wcaokaze/NotEnoughCompromises/scad/CircuitBoard.scad

circuit_board_thickness = 0.6;
