wcaokaze/NotEnoughCompromises/scad/PrinterSpec.scad

// 他のパーツと接触する部分において干渉を避けるために余分に開ける空間の大きさ
printer_min_margin = 0.1;
