wcaokaze/NotEnoughCompromises/scad/RubberFeet.scad

include <KeySwitch.scad>

rubber_feet_material_min_thickness = 1.0;

rubber_feet_thickness = rubber_feet_material_min_thickness;
