wcaokaze/NotEnoughCompromises/pcb/NotEnoughCompromises.kicad_pcb

## KiCad design pcb/NotEnoughCompromises.kicad_pcb (2024-10-13)

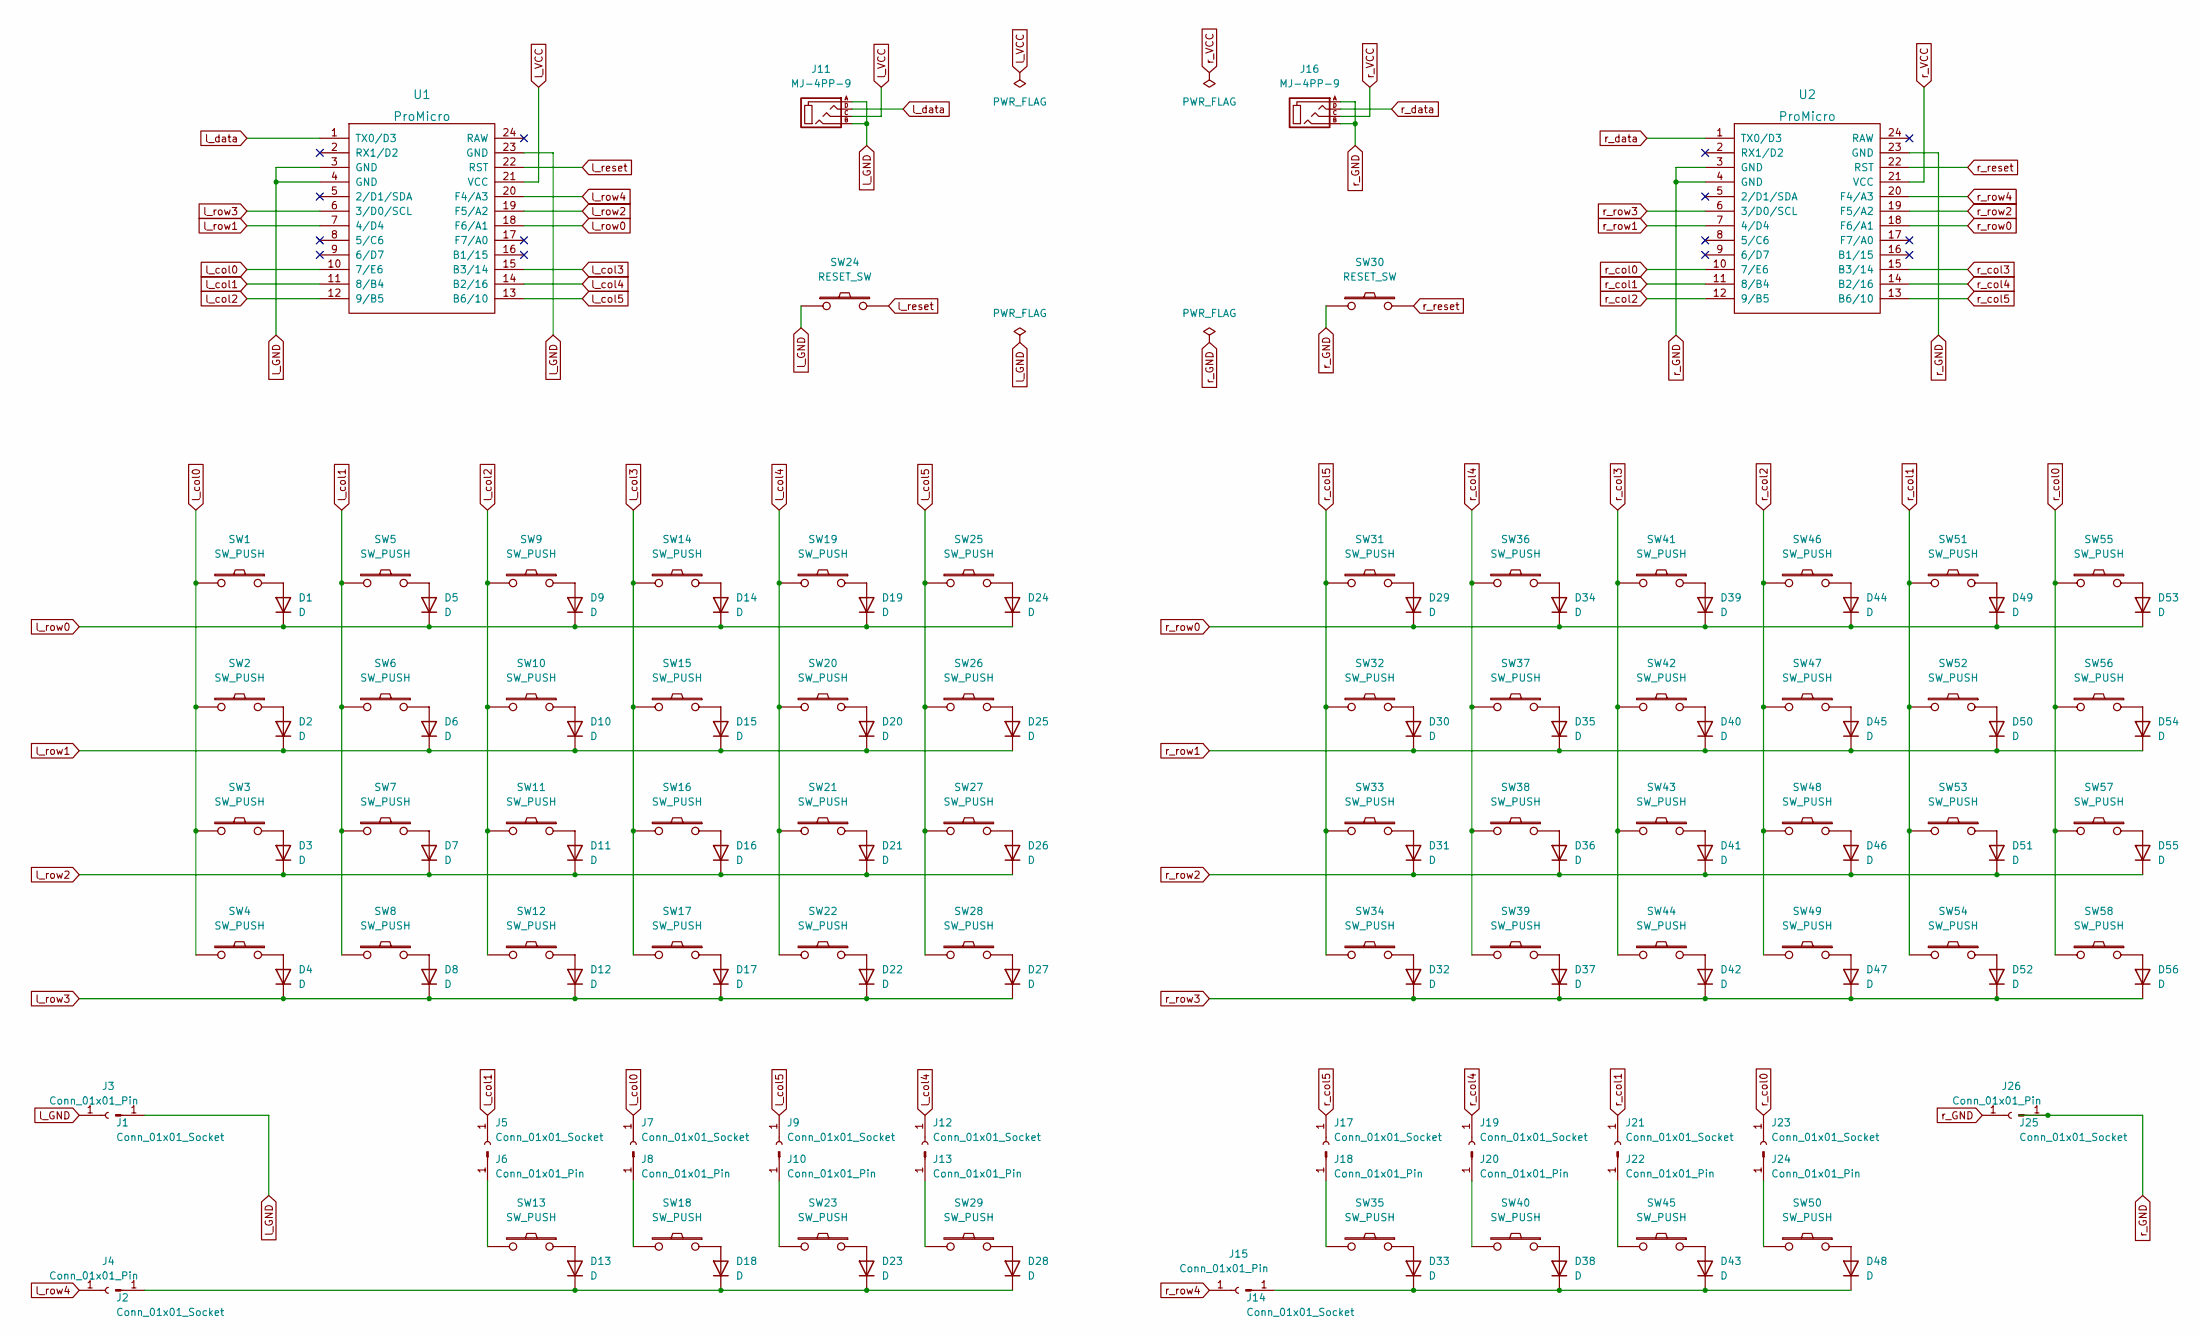
[picture p1: schematic NotEnoughCompromises.kicad_sch]

Parts:
D1, D2, D3, D4, D5, D6, D7, D8, D9, D10, D11, D12, D13, D14, D15, D16, D17, D18, D19, D20, D21, D22, D23, D24, D25, D26, D27, D28, D29, D30, D31, D32, D33, D34, D35, D36, D37, D38, D39, D40, D41, D42, D43, D44, D45, D46, D47, D48, D49, D50, D51, D52, D53, D54, D55, D56: D; D3_SMD_v2
J1, J2, J5, J7, J9, J12, J14, J17, J19, J21, J23, J25: Conn_01x01_Socket; SolderWirePad_1x01_SMD_1x2mm
J3, J4, J6, J8, J10, J13, J15, J18, J20, J22, J24, J26: Conn_01x01_Pin; SolderWirePad_1x01_SMD_1x2mm
J11, J16: MJ-4PP-9; MJ-4PP-9_1side
SW1, SW2, SW3, SW4, SW5, SW6, SW7, SW8, SW9, SW10, SW11, SW12, SW13, SW14, SW15, SW16, SW17, SW18, SW19, SW20, SW21, SW22, SW23, SW25, SW26, SW27, SW28, SW29, SW31, SW32, SW33, SW34, SW35, SW36, SW37, SW38, SW39, SW40, SW41, SW42, SW43, SW44, SW45, SW46, SW47, SW48, SW49, SW50, SW51, SW52, SW53, SW54, SW55, SW56, SW57, SW58: SW_PUSH; choc_v1
SW24, SW30: RESET_SW; reset_sw
U1, U2: ProMicro; ProMicro_v3.5

Connections:
unnamed: D1.2 (A), SW1.1
unnamed: D2.2 (A), SW2.1
unnamed: D3.2 (A), SW3.1
unnamed: D4.2 (A), SW4.1
unnamed: D5.2 (A), SW5.1
unnamed: D6.2 (A), SW6.1
unnamed: D7.2 (A), SW7.1
unnamed: D8.2 (A), SW8.1
unnamed: D9.2 (A), SW9.1
unnamed: D10.2 (A), SW10.1
unnamed: D11.2 (A), SW11.1
unnamed: D12.2 (A), SW12.1
unnamed: D13.2 (A), SW13.1
unnamed: D13.1 (K), D18.1 (K), D23.1 (K), D28.1 (K), J4.1
unnamed: D14.2 (A), SW14.1
unnamed: D15.2 (A), SW15.1
unnamed: D16.2 (A), SW16.1
unnamed: D17.2 (A), SW17.1
unnamed: D18.2 (A), SW18.1
unnamed: D19.2 (A), SW19.1
unnamed: D20.2 (A), SW20.1
unnamed: D21.2 (A), SW21.1
unnamed: D22.2 (A), SW22.1
unnamed: D23.2 (A), SW23.1
unnamed: D24.2 (A), SW25.1
unnamed: D25.2 (A), SW26.1
unnamed: D26.2 (A), SW27.1
unnamed: D27.2 (A), SW28.1
unnamed: D28.2 (A), SW29.1
unnamed: D29.2 (A), SW31.1
unnamed: D30.2 (A), SW32.1
unnamed: D31.2 (A), SW33.1
unnamed: D32.2 (A), SW34.1
unnamed: D33.2 (A), SW35.1
unnamed: D33.1 (K), D38.1 (K), D43.1 (K), D48.1 (K), J15.1
unnamed: D34.2 (A), SW36.1
unnamed: D35.2 (A), SW37.1
unnamed: D36.2 (A), SW38.1
unnamed: D37.2 (A), SW39.1
unnamed: D38.2 (A), SW40.1
unnamed: D39.2 (A), SW41.1
unnamed: D40.2 (A), SW42.1
unnamed: D41.2 (A), SW43.1
unnamed: D42.2 (A), SW44.1
unnamed: D43.2 (A), SW45.1
unnamed: D44.2 (A), SW46.1
unnamed: D45.2 (A), SW47.1
unnamed: D46.2 (A), SW48.1
unnamed: D47.2 (A), SW49.1
unnamed: D48.2 (A), SW50.1
unnamed: D49.2 (A), SW51.1
unnamed: D50.2 (A), SW52.1
unnamed: D51.2 (A), SW53.1
unnamed: D52.2 (A), SW54.1
unnamed: D53.2 (A), SW55.1
unnamed: D54.2 (A), SW56.1
unnamed: D55.2 (A), SW57.1
unnamed: D56.2 (A), SW58.1
unnamed: J6.1, SW13.2
unnamed: J8.1, SW18.2
unnamed: J10.1, SW23.2
unnamed: J13.1, SW29.2
unnamed: J18.1, SW35.2
unnamed: J20.1, SW40.2
unnamed: J22.1, SW45.2
unnamed: J24.1, SW50.2
l_GND: J1.1, J3.1, J11.A, J11.B, SW24.1, U1.3 (GND), U1.4 (GND), U1.23 (GND)
l_VCC: J11.C, U1.21 (VCC)
l_col0: J7.1, SW1.2, SW2.2, SW3.2, SW4.2, U1.10 (7/E6)
l_col1: J5.1, SW5.2, SW6.2, SW7.2, SW8.2, U1.11 (8/B4)
l_col2: SW9.2, SW10.2, SW11.2, SW12.2, U1.12 (9/B5)
l_col3: SW14.2, SW15.2, SW16.2, SW17.2, U1.15 (B3/14)
l_col4: J12.1, SW19.2, SW20.2, SW21.2, SW22.2, U1.14 (B2/16)
l_col5: J9.1, SW25.2, SW26.2, SW27.2, SW28.2, U1.13 (B6/10)
l_data: J11.D, U1.1 (TX0/D3)
l_reset: SW24.2, U1.22 (RST)
l_row0: D1.1 (K), D5.1 (K), D9.1 (K), D14.1 (K), D19.1 (K), D24.1 (K), U1.18 (F6/A1)
l_row1: D2.1 (K), D6.1 (K), D10.1 (K), D15.1 (K), D20.1 (K), D25.1 (K), U1.7 (4/D4)
l_row2: D3.1 (K), D7.1 (K), D11.1 (K), D16.1 (K), D21.1 (K), D26.1 (K), U1.19 (F5/A2)
l_row3: D4.1 (K), D8.1 (K), D12.1 (K), D17.1 (K), D22.1 (K), D27.1 (K), U1.6 (3/D0/SCL)
l_row4: J2.1, U1.20 (F4/A3)
r_GND: J16.A, J16.B, J25.1, J26.1, SW30.1, U2.3 (GND), U2.4 (GND), U2.23 (GND)
r_VCC: J16.C, U2.21 (VCC)
r_col0: J23.1, SW55.2, SW56.2, SW57.2, SW58.2, U2.10 (7/E6)
r_col1: J21.1, SW51.2, SW52.2, SW53.2, SW54.2, U2.11 (8/B4)
r_col2: SW46.2, SW47.2, SW48.2, SW49.2, U2.12 (9/B5)
r_col3: SW41.2, SW42.2, SW43.2, SW44.2, U2.15 (B3/14)
r_col4: J19.1, SW36.2, SW37.2, SW38.2, SW39.2, U2.14 (B2/16)
r_col5: J17.1, SW31.2, SW32.2, SW33.2, SW34.2, U2.13 (B6/10)
r_data: J16.D, U2.1 (TX0/D3)
r_reset: SW30.2, U2.22 (RST)
r_row0: D29.1 (K), D34.1 (K), D39.1 (K), D44.1 (K), D49.1 (K), D53.1 (K), U2.18 (F6/A1)
r_row1: D30.1 (K), D35.1 (K), D40.1 (K), D45.1 (K), D50.1 (K), D54.1 (K), U2.7 (4/D4)
r_row2: D31.1 (K), D36.1 (K), D41.1 (K), D46.1 (K), D51.1 (K), D55.1 (K), U2.19 (F5/A2)
r_row3: D32.1 (K), D37.1 (K), D42.1 (K), D47.1 (K), D52.1 (K), D56.1 (K), U2.6 (3/D0/SCL)
r_row4: J14.1, U2.20 (F4/A3)

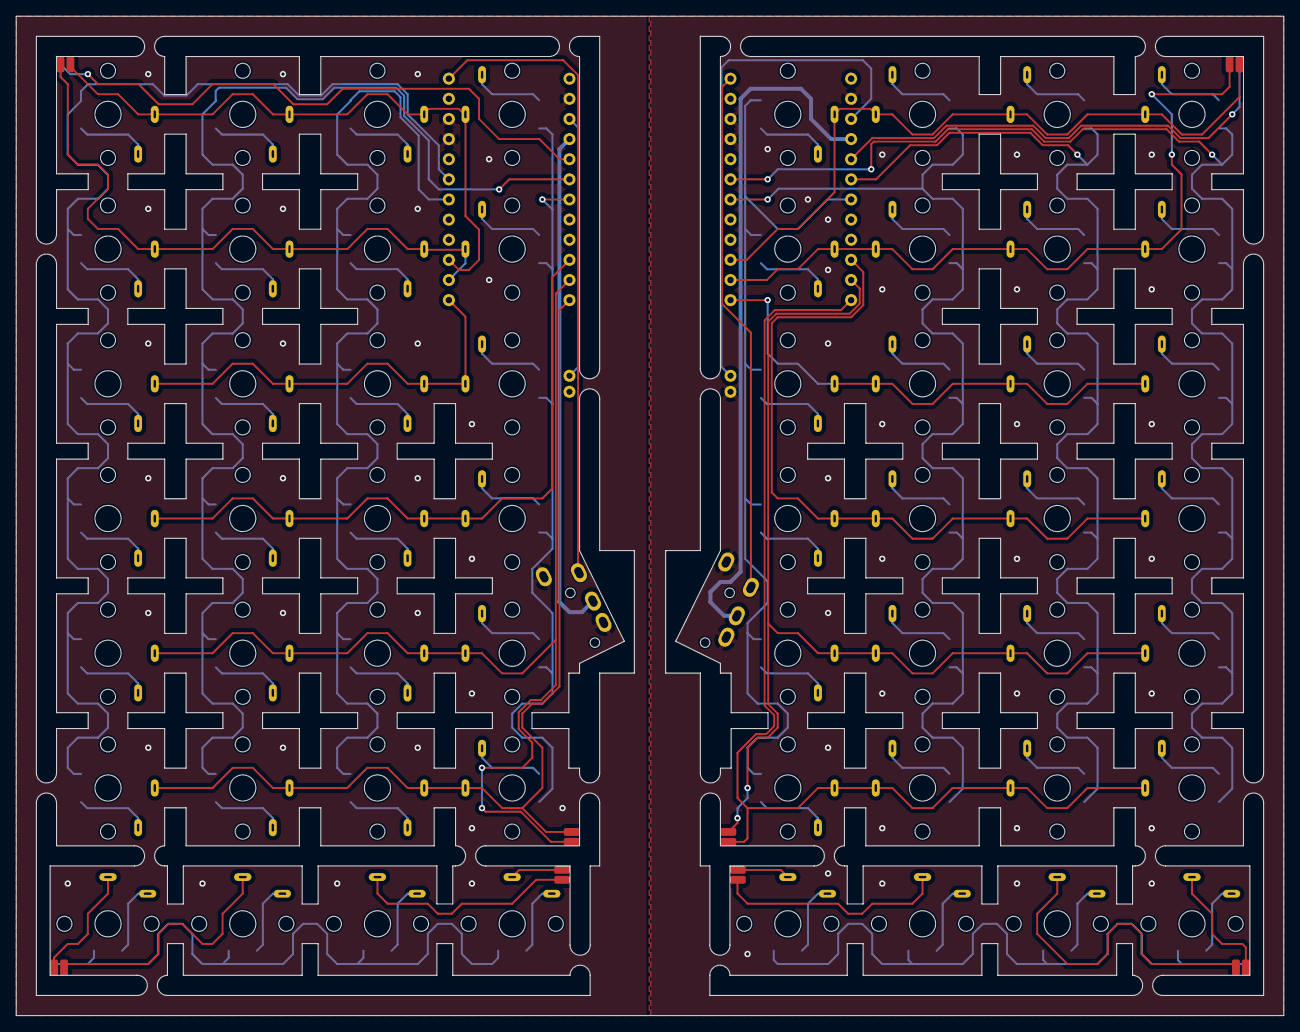
[picture p2: board NotEnoughCompromises.kicad_pcb from above]

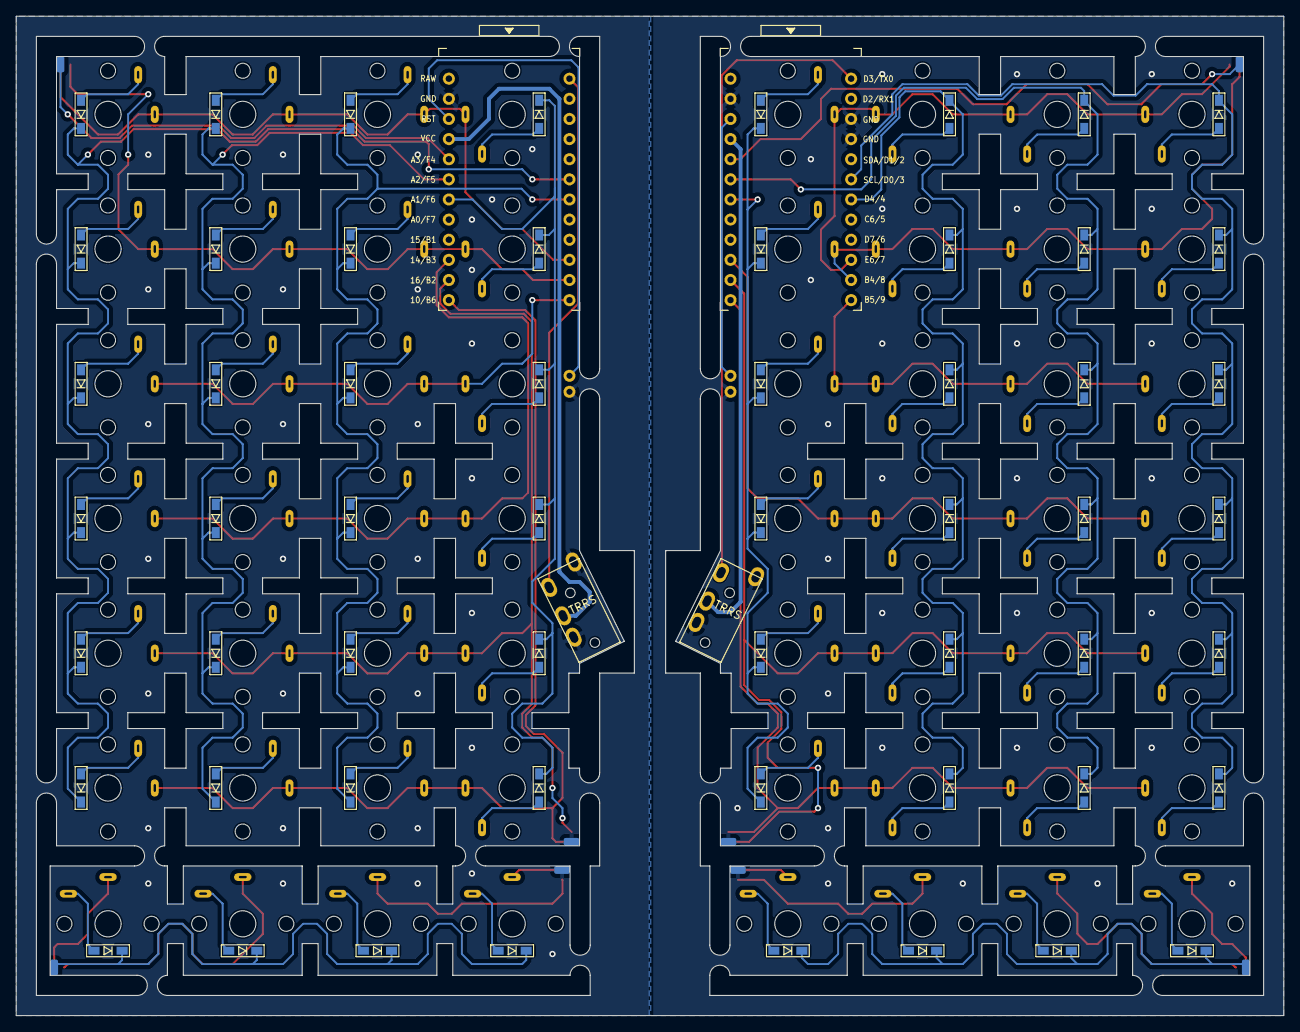
[picture p3: board NotEnoughCompromises.kicad_pcb from below]

Board: 2 copper layers, 159.9 x 126.1 mm, 142 parts (68 on the bottom side), 96 nets.
