wcaokaze/NotEnoughCompromises/(commit log)

2023-09-12 親指部分のケースの大きさの立方体を置いた
    [Case.scad, KeySwitch.scad, Keyboard.scad, NotEnoughCoumpromises.scad]
2023-09-13 親指部分のケースにキースイッチを通すための穴を開けた
    [Case.scad, KeySwitch.scad, PrinterSpec.scad]
2023-09-14 thumb_caseの引数にprinter_friendly_position: boolを追加。trueのときプリンタにやさしい向きで出力するようにした
    [Case.scad]
2023-09-14 基板の位置にcubeを置いた
    [Case.scad, CircuitBoard.scad, NotEnoughCoumpromises.scad]
2023-09-15 alphanumericのケースと基板を追加
    [Case.scad, CircuitBoard.scad, Keyboard.scad, NotEnoughCoumpromises.scad]
2023-09-16 ゴム足の土台を作成
    [NotEnoughCoumpromises.scad, RubberFeet.scad]
2023-09-17 ゴム足に開ける穴をケースの穴と同じにしてしまっていたのでスイッチの下半分の大きさに修正
    [RubberFeet.scad]
2023-09-17 「左手前のキーの位置」にcase_placement_positionというややこしい名前がついていたのでcase_leftfront_key_placement_positionに変更
    [Case.scad, RubberFeet.scad]
2023-09-17 なぜかハウジングという名称をすっかり忘れていたためハウジング関係の命名をhousingに変更
    [Case.scad, CircuitBoard.scad, KeySwitch.scad, Keyboard.scad, RubberFeet.scad]
2023-09-18 キースイッチの各部位の位置がわかるようにした
    [KeySwitch.scad]
2023-09-18 キーの位置計算をより正しく変更
    [Case.scad, CircuitBoard.scad, RubberFeet.scad]
2023-09-26 透明板の大きさのcubeを配置
    [Case.scad, ClearMarginBoard.scad, NotEnoughCoumpromises.scad]
2023-09-26 親指部のゴム足を追加
    [NotEnoughCoumpromises.scad, RubberFeet.scad]
2023-09-27 透明板にケースとゴム足用のスペースを空けた
    [ClearMarginBoard.scad, Keyboard.scad, NotEnoughCoumpromises.scad]
2023-09-30 基板の左右に余白を追加
    [CircuitBoard.scad]
2023-09-30 基板、一旦スイッチがあるとこだけにした
    [CircuitBoard.scad]
2023-09-30 基板のキースイッチ部分同士をつなげた
    [CircuitBoard.scad]
2023-10-01 透明板にキースイッチを通す穴を空けた
    [ClearMarginBoard.scad]
2023-10-02 透明板に基板配置ようのスペースを空けた
    [CircuitBoard.scad, ClearMarginBoard.scad]
2023-10-04 透明板がケースの高さまで埋まるようにした
    [Case.scad, ClearMarginBoard.scad]
2023-10-07 親指キーの手前と数字行の奥にあった透明板の枠を外した
    [ClearMarginBoard.scad]
2023-10-09 include忘れなどを修正
    [ClearMarginBoard.scad, RubberFeet.scad]
2023-10-09 透明板の親指部分が0.1mm薄かったのを修正
    [ClearMarginBoard.scad]
2023-10-09 透明板を薄くした。基板に挿す部分だけ0.5mmはみ出させた
    [Case.scad, ClearMarginBoard.scad]
2023-10-10 ゴム足を基板の下に厚さ1mmで敷く形状に変更
    [CircuitBoard.scad, ClearMarginBoard.scad, RubberFeet.scad]
2023-10-14 各パーツのmodule内でtranslateするようにした
    [Case.scad, CircuitBoard.scad, ClearMarginBoard.scad, NotEnoughCoumpromises.scad, RubberFeet.scad]
2023-10-14 チルトできるようにした
    [Keyboard.scad, NotEnoughCoumpromises.scad, RubberFeet.scad]
2023-10-14 ゴム足にマイコン用のスペースを空けた
    [Keyboard.scad, RubberFeet.scad, rotate.scad]
2023-10-14 ゴム足の四隅にマージンをつけた
    [RubberFeet.scad]
2023-10-14 透明板を半透明にした
    [NotEnoughCoumpromises.scad]
2023-10-20 透明板とゴム足の基板に挿す部分を作った
    [ClearMarginBoard.scad, Keyboard.scad, RubberFeet.scad]
2023-10-20 ゴム足がキースイッチと干渉しないようにした
    [RubberFeet.scad]
2023-10-27 ゴム足に透明板を挿す穴を開けた
    [ClearMarginBoard.scad, RubberFeet.scad]
2023-10-27 ゴム足、透明板もケースと同様にprinter_friendly_positionで出力できるようにした
    [ClearMarginBoard.scad, RubberFeet.scad]
2023-10-27 ゴム足に十分な厚さがあるときは透明板用の穴を貫通させないようにした
    [RubberFeet.scad]
2023-10-29 KiCadプロジェクト作成
    [NotEnoughCompromises.kicad_pcb, NotEnoughCompromises.kicad_sch]
2023-11-01 回路図を作成
    [NotEnoughCompromises.kicad_sch]
2023-11-08 部品を配置した
    [NotEnoughCompromises.kicad_pcb, NotEnoughCompromises.kicad_sch]
2024-10-13 基板を作成
    [NotEnoughCompromises-B_Cu.gbr, NotEnoughCompromises-B_Mask.gbr, NotEnoughCompromises-B_Silkscreen.gbr, NotEnoughCompromises-Edge_Cuts.gbr, NotEnoughCompromises-F_Cu.gbr, NotEnoughCompromises-F_Mask.gbr, NotEnoughCompromises-F_Silkscreen.gbr, NotEnoughCompromises-NPTH.drl]
